salty-muffin/vfd-iv-18-clock/README.md

# vfd-iv-18-clock

A clock build around a iv-18 vacuum flourecent display

all libraries in the lib directory must be copied to the lib directory of the raspberry pi pico (all python files in the subdirectories should be copied directly)
