salty-muffin/vfd-iv-18-clock/pcb/pcb.kicad_pcb

## KiCad design pcb/pcb.kicad_pcb (2023-11-26)

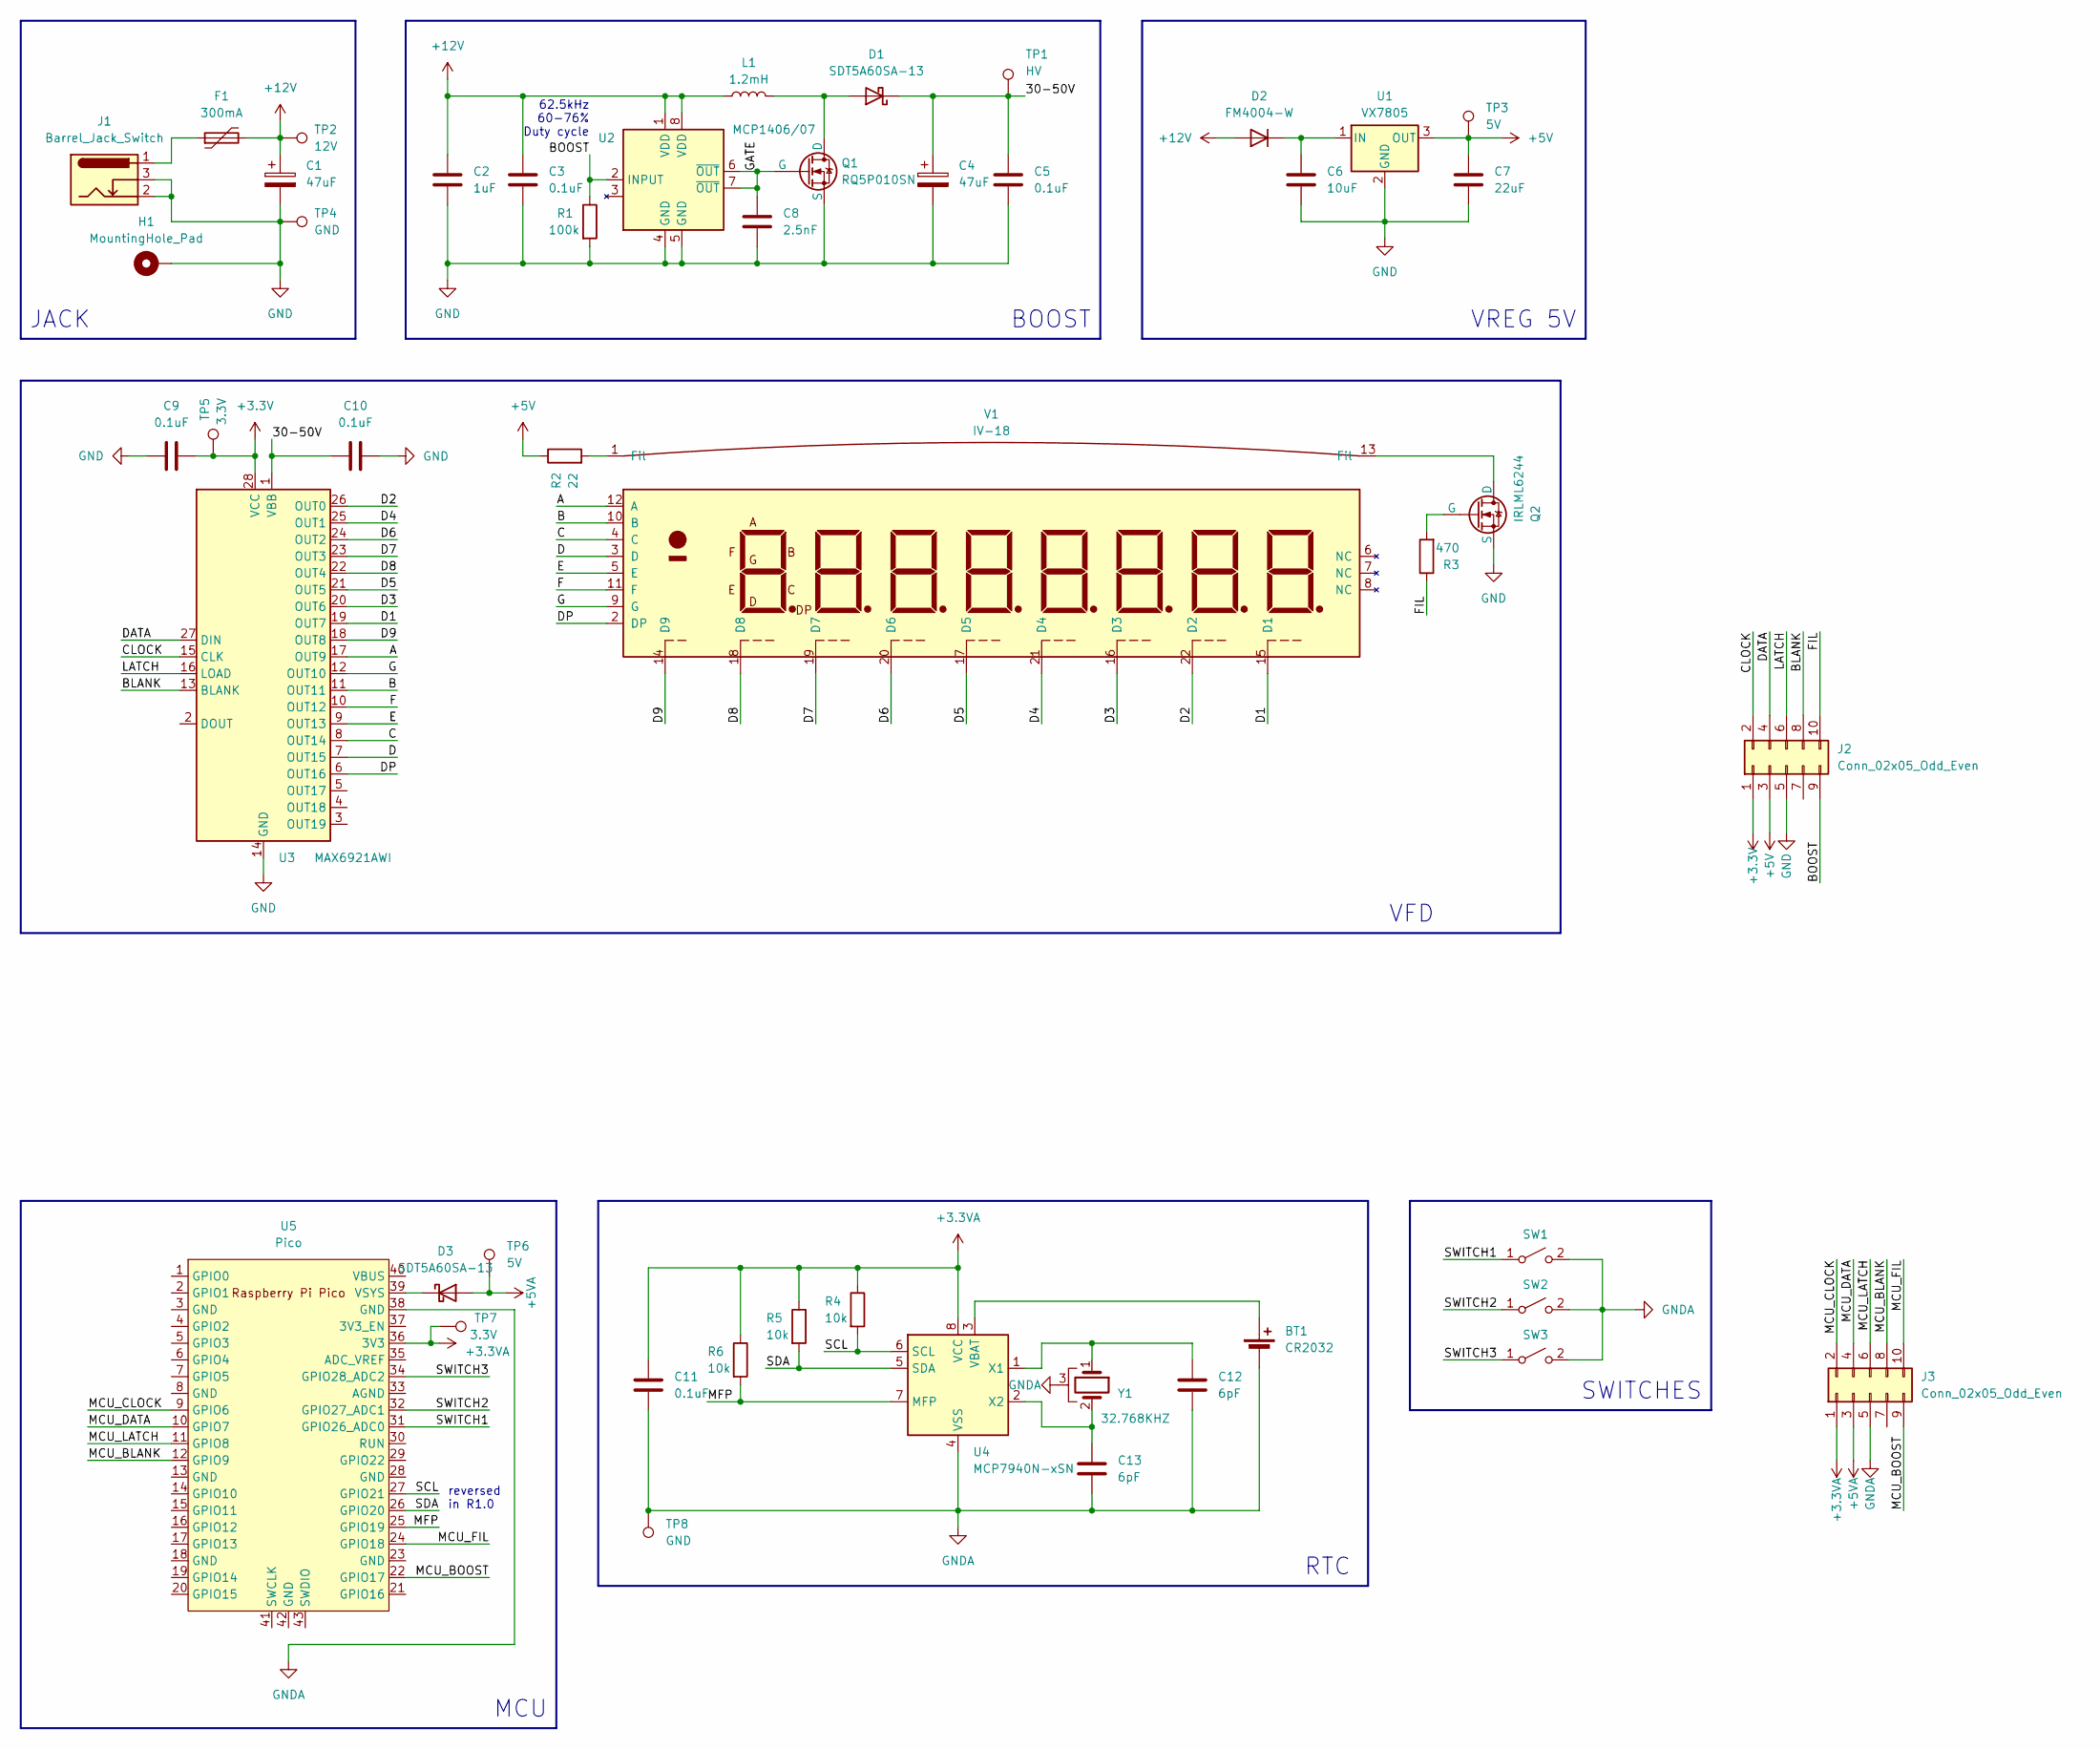
[picture p1: schematic pcb.kicad_sch]

Parts:
BT1: CR2032; BatteryHolder_Keystone_3002_1x2032
C1, C4: 47uF; CP_Radial_D8.0mm_P3.50mm
C2: 1uF; C_Rect_L7.2mm_W5.5mm_P5.00mm_FKS2_FKP2_MKS2_MKP2
C3, C5, C9, C10, C11: 0.1uF; C_1206_3216Metric_Pad1.33x1.80mm_HandSolder
C6: 10uF; C_1206_3216Metric_Pad1.33x1.80mm_HandSolder
C7: 22uF; C_1206_3216Metric_Pad1.33x1.80mm_HandSolder
C8: 2.5nF; C_1206_3216Metric_Pad1.33x1.80mm_HandSolder
C12, C13: 6pF; C_1206_3216Metric_Pad1.33x1.80mm_HandSolder
D1, D3: SDT5A60SA-13; D_SMA_Handsoldering
D2: FM4004-W; D_SMA_Handsoldering
F1: 300mA; Fuse_1812_4532Metric_Pad1.30x3.40mm_HandSolder
H1: MountingHole_Pad; MountingHole_3.2mm_M3_DIN965_Pad
J1: Barrel_Jack_Switch; BarrelJack_Wuerth_6941xx301002
J2, J3: Conn_02x05_Odd_Even; PinSocket_2x05_P2.54mm_Vertical
L1: 1.2mH; L_Radial_D9.5mm_P5.00mm_Fastron_07HVP
Q1: RQ5P010SN; SOT-23_Handsoldering
Q2: IRLML6244; SOT-23_Handsoldering
R1: 100k; R_1206_3216Metric_Pad1.30x1.75mm_HandSolder
R2: 22; R_1206_3216Metric_Pad1.30x1.75mm_HandSolder
R3: 470; R_1206_3216Metric_Pad1.30x1.75mm_HandSolder
R4, R5, R6: 10k; R_1206_3216Metric_Pad1.30x1.75mm_HandSolder
SW1, SW2, SW3: SW_SPST; SW_Tactile_SPST_Angled_PTS645Vx83-2LFS
TP1: HV; TestPoint_THTPad_D1.5mm_Drill0.7mm
TP2: 12V; TestPoint_THTPad_D1.5mm_Drill0.7mm
TP3, TP6: 5V; TestPoint_THTPad_D1.5mm_Drill0.7mm
TP4, TP8: GND; TestPoint_THTPad_D1.5mm_Drill0.7mm
TP5, TP7: 3.3V; TestPoint_THTPad_D1.5mm_Drill0.7mm
U1: VX7805
U2: MCP1406/07; SOIC-8_3.9x4.9mm_P1.27mm
U3: MAX6921AWI; SOIC-28W_7.5x17.9mm_P1.27mm
U4: MCP7940N-xSN; SOIC-8_3.9x4.9mm_P1.27mm
U5: Pico; RPi_Pico_SMD
V1: IV-18
Y1: 32.768KHZ; Crystal_DS26_D2.0mm_L6.0mm_Horizontal_Grounded_SMT

Connections:
+3.3V: C9.2, J2.1, TP5.1, U3.28 (VCC)
+3.3VA: C11.1, J3.1, R4.1, R5.1, R6.1, TP7.1, U4.8 (VCC), U5.36 (3V3)
+5V: C7.1, J2.3, R2.1, TP3.1, U1.3 (OUT)
+5VA: D3.2 (A), J3.3, TP6.1
+12V: C1.1, C2.1, C3.1, D2.2 (A), F1.2, L1.1, TP2.1, U2.1 (VDD), U2.8 (VDD)
/30-50V: C4.1, C5.1, C10.1, D1.1 (K), TP1.1, U3.1 (VBB)
/A: U3.17 (OUT9), V1.12 (A)
/B: U3.11 (OUT11), V1.10 (B)
/BLANK: J2.8, U3.13 (BLANK)
/BOOST: J2.9, R1.1, U2.2 (INPUT)
/C: U3.8 (OUT14), V1.4 (C)
/CLOCK: J2.2, U3.15 (CLK)
/D: U3.7 (OUT15), V1.3 (D)
/D1: U3.19 (OUT7), V1.15 (D1)
/D2: U3.26 (OUT0), V1.22 (D2)
/D3: U3.20 (OUT6), V1.16 (D3)
/D4: U3.25 (OUT1), V1.21 (D4)
/D5: U3.21 (OUT5), V1.17 (D5)
/D6: U3.24 (OUT2), V1.20 (D6)
/D7: U3.23 (OUT3), V1.19 (D7)
/D8: U3.22 (OUT4), V1.18 (D8)
/D9: U3.18 (OUT8), V1.14 (D9)
/DATA: J2.4, U3.27 (DIN)
/DP: U3.6 (OUT16), V1.2 (DP)
/E: U3.9 (OUT13), V1.5 (E)
/F: U3.10 (OUT12), V1.11 (F)
/FIL: J2.10, R3.1
/G: U3.12 (OUT10), V1.9 (G)
/GATE: C8.1, Q1.1 (G), U2.6 (~OUT), U2.7 (~OUT)
/LATCH: J2.6, U3.16 (LOAD)
/MCU_BLANK: J3.8, U5.12 (GPIO9)
/MCU_BOOST: J3.9, U5.22 (GPIO17)
/MCU_CLOCK: J3.2, U5.9 (GPIO6)
/MCU_DATA: J3.4, U5.10 (GPIO7)
/MCU_FIL: J3.10, U5.24 (GPIO18)
/MCU_LATCH: J3.6, U5.11 (GPIO8)
/MFP: R6.2, U4.7 (MFP), U5.25 (GPIO19)
/SCL: R4.2, U4.6 (SCL), U5.27 (GPIO21)
/SDA: R5.2, U4.5 (SDA), U5.26 (GPIO20)
/SWITCH1: SW1.1 (A), U5.31 (GPIO26_ADC0)
/SWITCH2: SW2.1 (A), U5.32 (GPIO27_ADC1)
/SWITCH3: SW3.1 (A), U5.34 (GPIO28_ADC2)
GND: C1.2, C2.2, C3.2, C4.2, C5.2, C6.2, C7.2, C8.2, C9.1, C10.2, H1.1, J1.2, J1.3, J2.5, Q1.2 (S), Q2.2 (S), R1.2, TP4.1, U1.2 (GND), U2.4 (GND), U2.5 (GND), U3.14 (GND)
GNDA: BT1.2 (-), C11.2, C12.2, C13.2, J3.5, SW1.2 (B), SW2.2 (B), SW3.2 (B), TP8.1, U4.4 (VSS), U5.38 (GND), Y1.3
unnamed: BT1.1 (+), U4.3 (VBAT)
unnamed: D1.2 (A), L1.2, Q1.3 (D)
unnamed: C6.1, D2.1 (K), U1.1 (IN)
unnamed: D3.1 (K), U5.39 (VSYS)
unnamed: F1.1, J1.1
unnamed: Q2.3 (D), V1.13 (Fil)
unnamed: Q2.1 (G), R3.2
unnamed: R2.2, V1.1 (Fil)
unnamed: C12.1, U4.1 (X1), Y1.1
unnamed: C13.1, U4.2 (X2), Y1.2

Notes on the sheet:
MCU
SWITCHES
62.5kHz 60-76% Duty cycle
reversed in R1.0
JACK
VFD
BOOST
VREG 5V
RTC

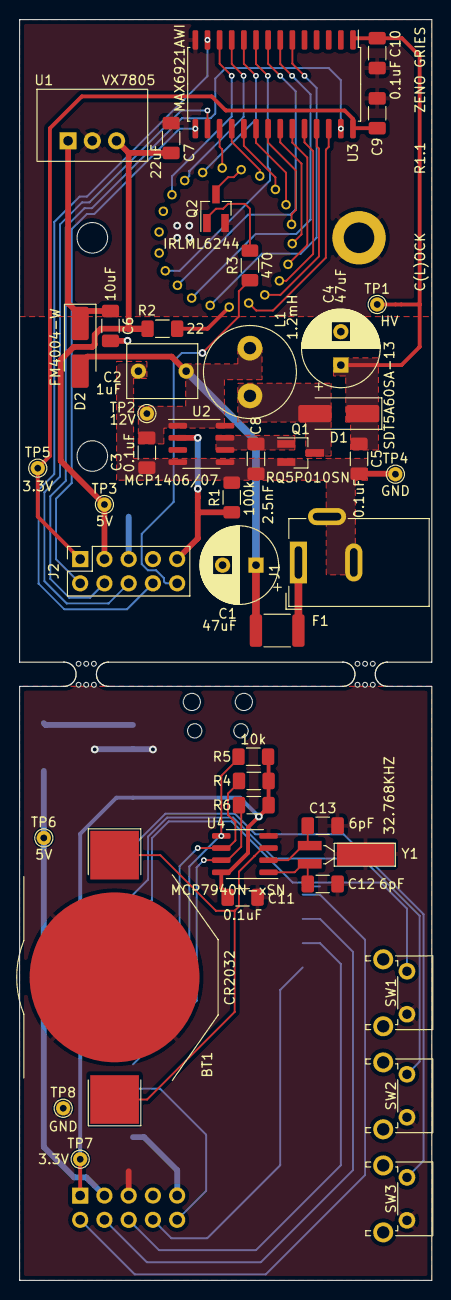
[picture p2: board pcb.kicad_pcb from above]

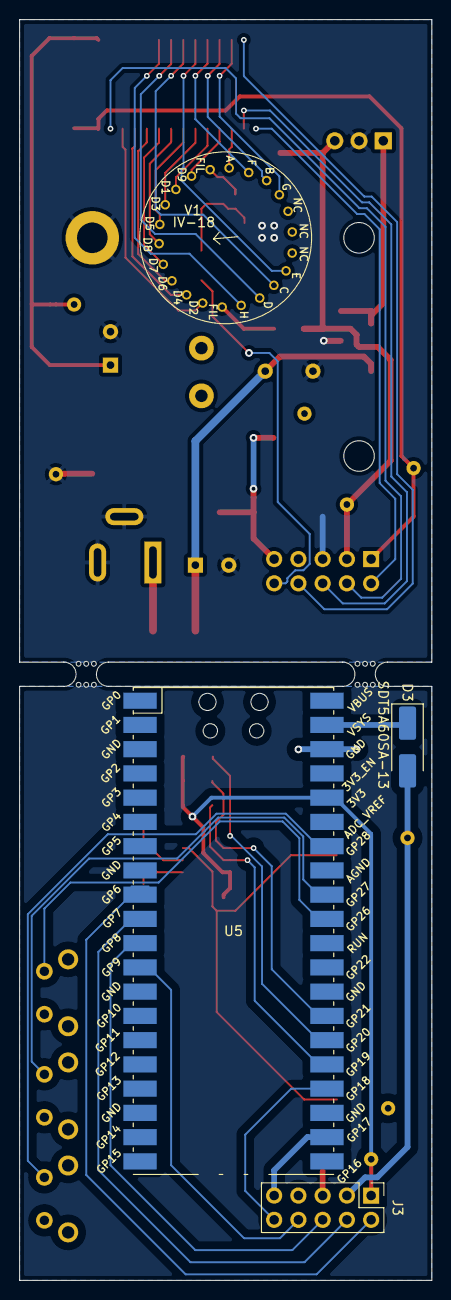
[picture p3: board pcb.kicad_pcb from below]

Board: 2 copper layers, 43.2 x 132.1 mm, 51 parts (3 on the bottom side), 54 nets.

Other parts of the board:
mouse-bite-2.54mm-slot, mouse-bite-2.54mm-slot#2: VAL**; mouse-bite-2.54mm-slot
