salty-muffin/vfd-iv-18-clock/(commit log)

2023-10-06 added pcb
    [pcb.kicad_pcb, pcb.kicad_sch]
2023-10-11 finished routing
    [pcb.kicad_pcb, pcb.kicad_sch]
2023-10-12 finished pcb
    [pcb.kicad_pcb, pcb.kicad_sch]
2023-10-12 fixed some traces
    [pcb.kicad_pcb]
2023-10-14 rotated display
    [pcb.kicad_pcb]
2023-10-14 added credentials
    [pcb.kicad_pcb]
2023-10-14 minor fixes
    [pcb.kicad_pcb]
2023-10-14 added bom
    [pcb.csv]
2023-10-15 new pcb design
    [pcb.csv, pcb.kicad_pcb, pcb.kicad_sch]
2023-10-16 small fixes
    [pcb.csv, pcb.kicad_pcb, pcb.kicad_sch]
2023-10-16 decreased costs
    [pcb.kicad_pcb]
2023-11-15 added info for boost converter signal
    [pcb.kicad_sch]
2023-11-20 added shift register code
    [pcb.kicad_sch]
2023-11-23 updated pcb to R1.1
    [pcb.kicad_pcb]
2023-11-25 added resettable fuse
    [pcb.kicad_pcb, pcb.kicad_sch]
2023-11-25 fixed display not blanking
    [main.py]
2023-11-26 exchanged lm7805 for vx7805
    [pcb.csv, pcb.kicad_pcb, pcb.kicad_sch]
2023-11-26 enabled battery backend consistently
2023-11-26 reintroduced mousebites
    [pcb.kicad_pcb]
2023-11-27 added test script for calibration
2023-11-28 finished calibration script
2023-12-03 added auto calibration script
